alangarf/NRC2016/docs/BillOfMaterials.md

9-pin resistor network:  
* mouser L091S103LF  
* farnell MCRNLA09G0103B0E

USB-B connector:  
* mouser 523-UE27-BC54-130
