alangarf/NRC2016/kicad/banked_ram/banked_ram.kicad_pcb

## KiCad design kicad/banked_ram/banked_ram.kicad_pcb (2016-09-17)

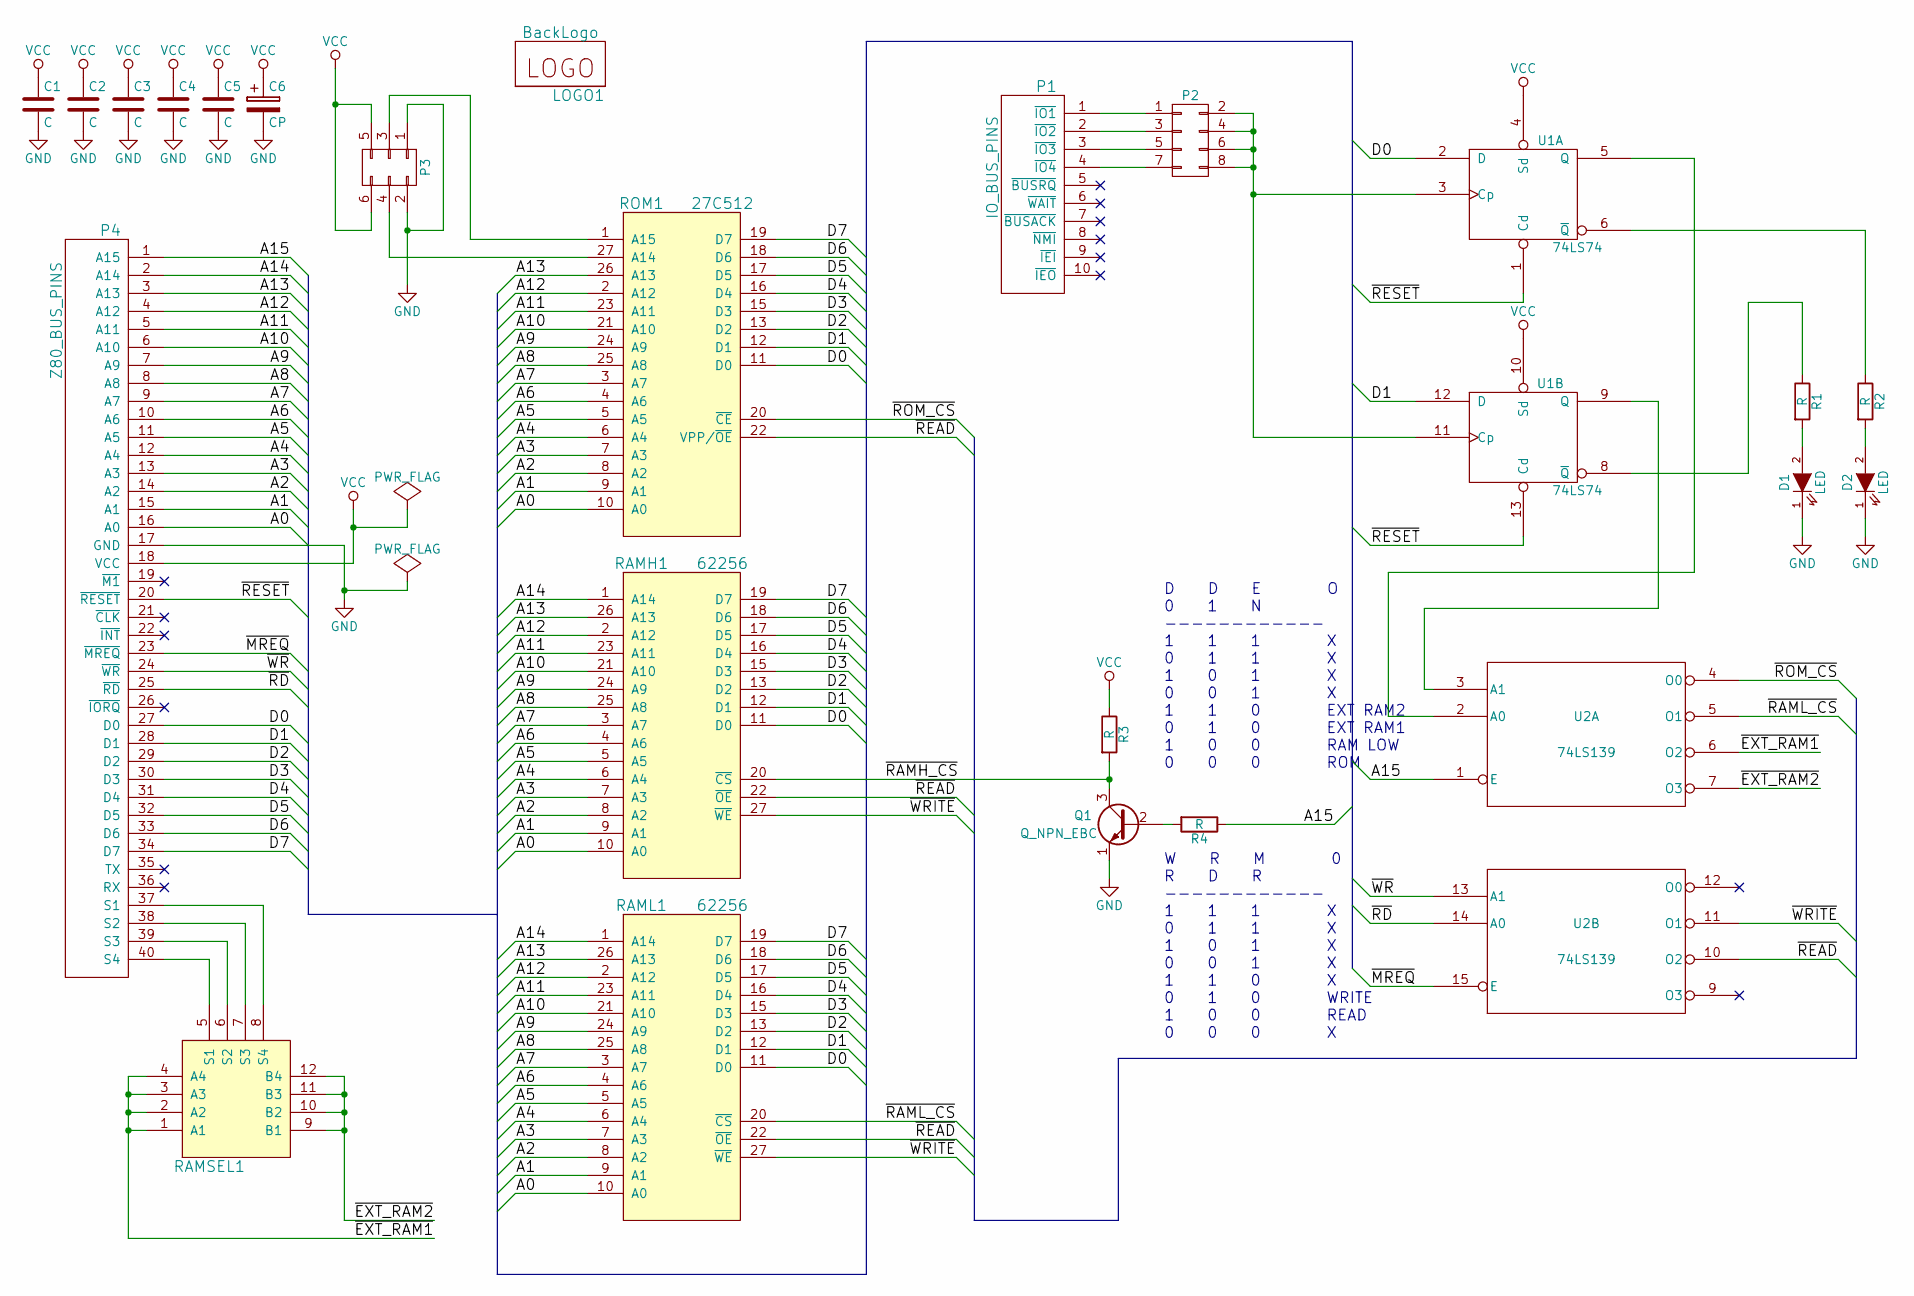
[picture p1: schematic banked_ram.sch]

Parts:
C1, C2, C3, C4, C5: C; C_Disc_D3_P2.5
C6: CP; C_Radial_D5_L11_P2.5
D1, D2: LED; LED-3MM
LOGO1: BackLogo; nrc2016_top_logo_1600
P1: IO_BUS_PINS; Pin_Header_Angled_1x10_nrc2016
P2: CONN_02X04; Pin_Header_Straight_2x04_nrc2016
P3: CONN_02X03; Pin_Header_Straight_2x03
P4: Z80_BUS_PINS; Pin_Header_Angled_1x40_nrc2016
Q1: Q_NPN_EBC; TO-92_Inline_Narrow_Oval
R1, R2, R3, R4: R; Resistor_Horizontal_RM10mm
RAMH1: 62256; DIP-28_W15.24mm_LongPads
RAML1: 62256; DIP-28_W15.24mm_LongPads
RAMSEL1: CONN_04x03; ramsel_pins
ROM1: 27C512; DIP-28_W15.24mm_LongPads
U1: 74LS74; DIP-14_W7.62mm_LongPads
U2: 74LS139; DIP-16_W7.62mm_LongPads

Connections:
/A0: P4.16 (A0), RAMH1.10 (A0), RAML1.10 (A0), ROM1.10 (A0)
/A1: P4.15 (A1), RAMH1.9 (A1), RAML1.9 (A1), ROM1.9 (A1)
/A2: P4.14 (A2), RAMH1.8 (A2), RAML1.8 (A2), ROM1.8 (A2)
/A3: P4.13 (A3), RAMH1.7 (A3), RAML1.7 (A3), ROM1.7 (A3)
/A4: P4.12 (A4), RAMH1.6 (A4), RAML1.6 (A4), ROM1.6 (A4)
/A5: P4.11 (A5), RAMH1.5 (A5), RAML1.5 (A5), ROM1.5 (A5)
/A6: P4.10 (A6), RAMH1.4 (A6), RAML1.4 (A6), ROM1.4 (A6)
/A7: P4.9 (A7), RAMH1.3 (A7), RAML1.3 (A7), ROM1.3 (A7)
/A8: P4.8 (A8), RAMH1.25 (A8), RAML1.25 (A8), ROM1.25 (A8)
/A9: P4.7 (A9), RAMH1.24 (A9), RAML1.24 (A9), ROM1.24 (A9)
/A10: P4.6 (A10), RAMH1.21 (A10), RAML1.21 (A10), ROM1.21 (A10)
/A11: P4.5 (A11), RAMH1.23 (A11), RAML1.23 (A11), ROM1.23 (A11)
/A12: P4.4 (A12), RAMH1.2 (A12), RAML1.2 (A12), ROM1.2 (A12)
/A13: P4.3 (A13), RAMH1.26 (A13), RAML1.26 (A13), ROM1.26 (A13)
/A14: P4.2 (A14), RAMH1.1 (A14), RAML1.1 (A14)
/A15: P4.1 (A15), R4.1, U2.1 (E)
/D0: P4.27 (D0), RAMH1.11 (D0), RAML1.11 (D0), ROM1.11 (D0), U1.2 (D)
/D1: P4.28 (D1), RAMH1.12 (D1), RAML1.12 (D1), ROM1.12 (D1), U1.12 (D)
/D2: P4.29 (D2), RAMH1.13 (D2), RAML1.13 (D2), ROM1.13 (D2)
/D3: P4.30 (D3), RAMH1.15 (D3), RAML1.15 (D3), ROM1.15 (D3)
/D4: P4.31 (D4), RAMH1.16 (D4), RAML1.16 (D4), ROM1.16 (D4)
/D5: P4.32 (D5), RAMH1.17 (D5), RAML1.17 (D5), ROM1.17 (D5)
/D6: P4.33 (D6), RAMH1.18 (D6), RAML1.18 (D6), ROM1.18 (D6)
/D7: P4.34 (D7), RAMH1.19 (D7), RAML1.19 (D7), ROM1.19 (D7)
/~EXT_RAM1: RAMSEL1.1 (A1), RAMSEL1.2 (A2), RAMSEL1.3 (A3), RAMSEL1.4 (A4), U2.6 (O2)
/~EXT_RAM2: RAMSEL1.9 (B1), RAMSEL1.10 (B2), RAMSEL1.11 (B3), RAMSEL1.12 (B4), U2.7 (O3)
/~MREQ: P4.23 (~MREQ), U2.15 (E)
/~RAMH_CS: Q1.3 (C), R3.2, RAMH1.20 (~CS)
/~RAML_CS: RAML1.20 (~CS), U2.5 (O1)
/~RD: P4.25 (~RD), U2.14 (A0)
/~READ: RAMH1.22 (~OE), RAML1.22 (~OE), ROM1.22 (VPP/~OE), U2.10 (O2)
/~RESET: P4.20 (~RESET), U1.1 (Cd), U1.13 (Cd)
/~ROM_CS: ROM1.20 (~CE), U2.4 (O0)
/~WR: P4.24 (~WR), U2.13 (A1)
/~WRITE: RAMH1.27 (~WE), RAML1.27 (~WE), U2.11 (O1)
GND: C1.2, C2.2, C3.2, C4.2, C5.2, C6.2, D1.1 (K), D2.1 (K), P3.1, P3.2, P4.17 (GND), Q1.1 (E), RAMH1.14 (GND), RAML1.14 (GND), ROM1.14 (GND), U1.7 (GND), U2.8 (GND)
unnamed: D1.2 (A), R1.2
unnamed: D2.2 (A), R2.2
unnamed: P1.1 (~IO1), P2.1
unnamed: P1.2 (~IO2), P2.3
unnamed: P1.3 (~IO3), P2.5
unnamed: P1.4 (~IO4), P2.7
unnamed: P2.2, P2.4, P2.6, P2.8, U1.3 (Cp), U1.11 (Cp)
unnamed: P3.3, ROM1.1 (A15)
unnamed: P3.4, ROM1.27 (A14)
unnamed: P4.37 (S1), RAMSEL1.8 (S4)
unnamed: P4.38 (S2), RAMSEL1.7 (S3)
unnamed: P4.39 (S3), RAMSEL1.6 (S2)
unnamed: P4.40 (S4), RAMSEL1.5 (S1)
unnamed: Q1.2 (B), R4.2
unnamed: R1.1, U1.8 (~Q)
unnamed: R2.1, U1.6 (~Q)
unnamed: U1.5 (Q), U2.2 (A0)
unnamed: U1.9 (Q), U2.3 (A1)
VCC: C1.1, C2.1, C3.1, C4.1, C5.1, C6.1, P3.5, P3.6, P4.18 (VCC), R3.1, RAMH1.28 (VCC), RAML1.28 (VCC), ROM1.28 (VCC), U1.4 (Sd), U1.10 (Sd), U1.14 (VCC), U2.16 (VCC)

Notes on the sheet:
W R M 0 R D R ------------ 1 1 1 X 0 1 1 X 1 0 1 X 0 0 1 X 1 1 0 X 0 1 0 WRITE 1 0 0 READ 0 0 0 X
D D E O 0 1 N ------------ 1 1 1 X 0 1 1 X 1 0 1 X 0 0 1 X 1 1 0 EXT RAM2 0 1 0 EXT RAM1 1 0 0 RAM LOW 0 0 0 ROM

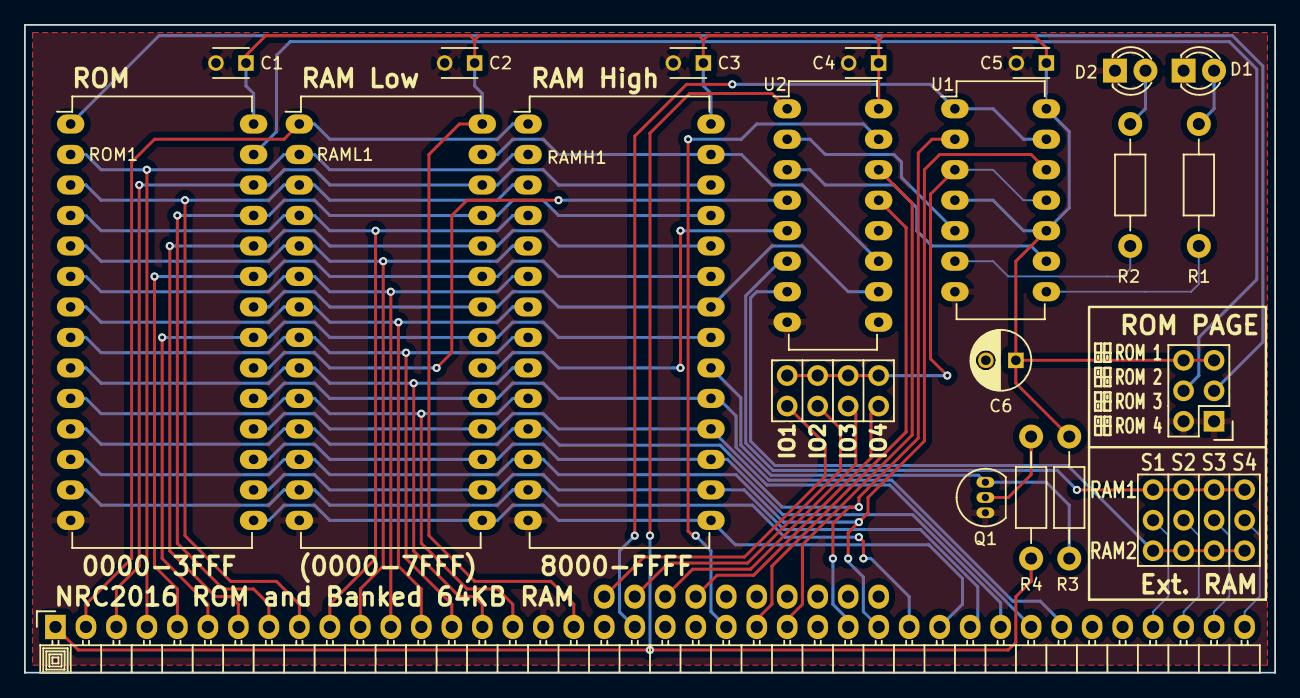
[picture p2: board banked_ram.kicad_pcb from above]

Board: 2 copper layers, 104.1 x 54.0 mm, 24 parts (0 on the bottom side), 55 nets.
