alangarf/NRC2016/kicad/usb_sio/usb_sio.kicad_pcb

## KiCad design kicad/usb_sio/usb_sio.kicad_pcb (2016-09-17)

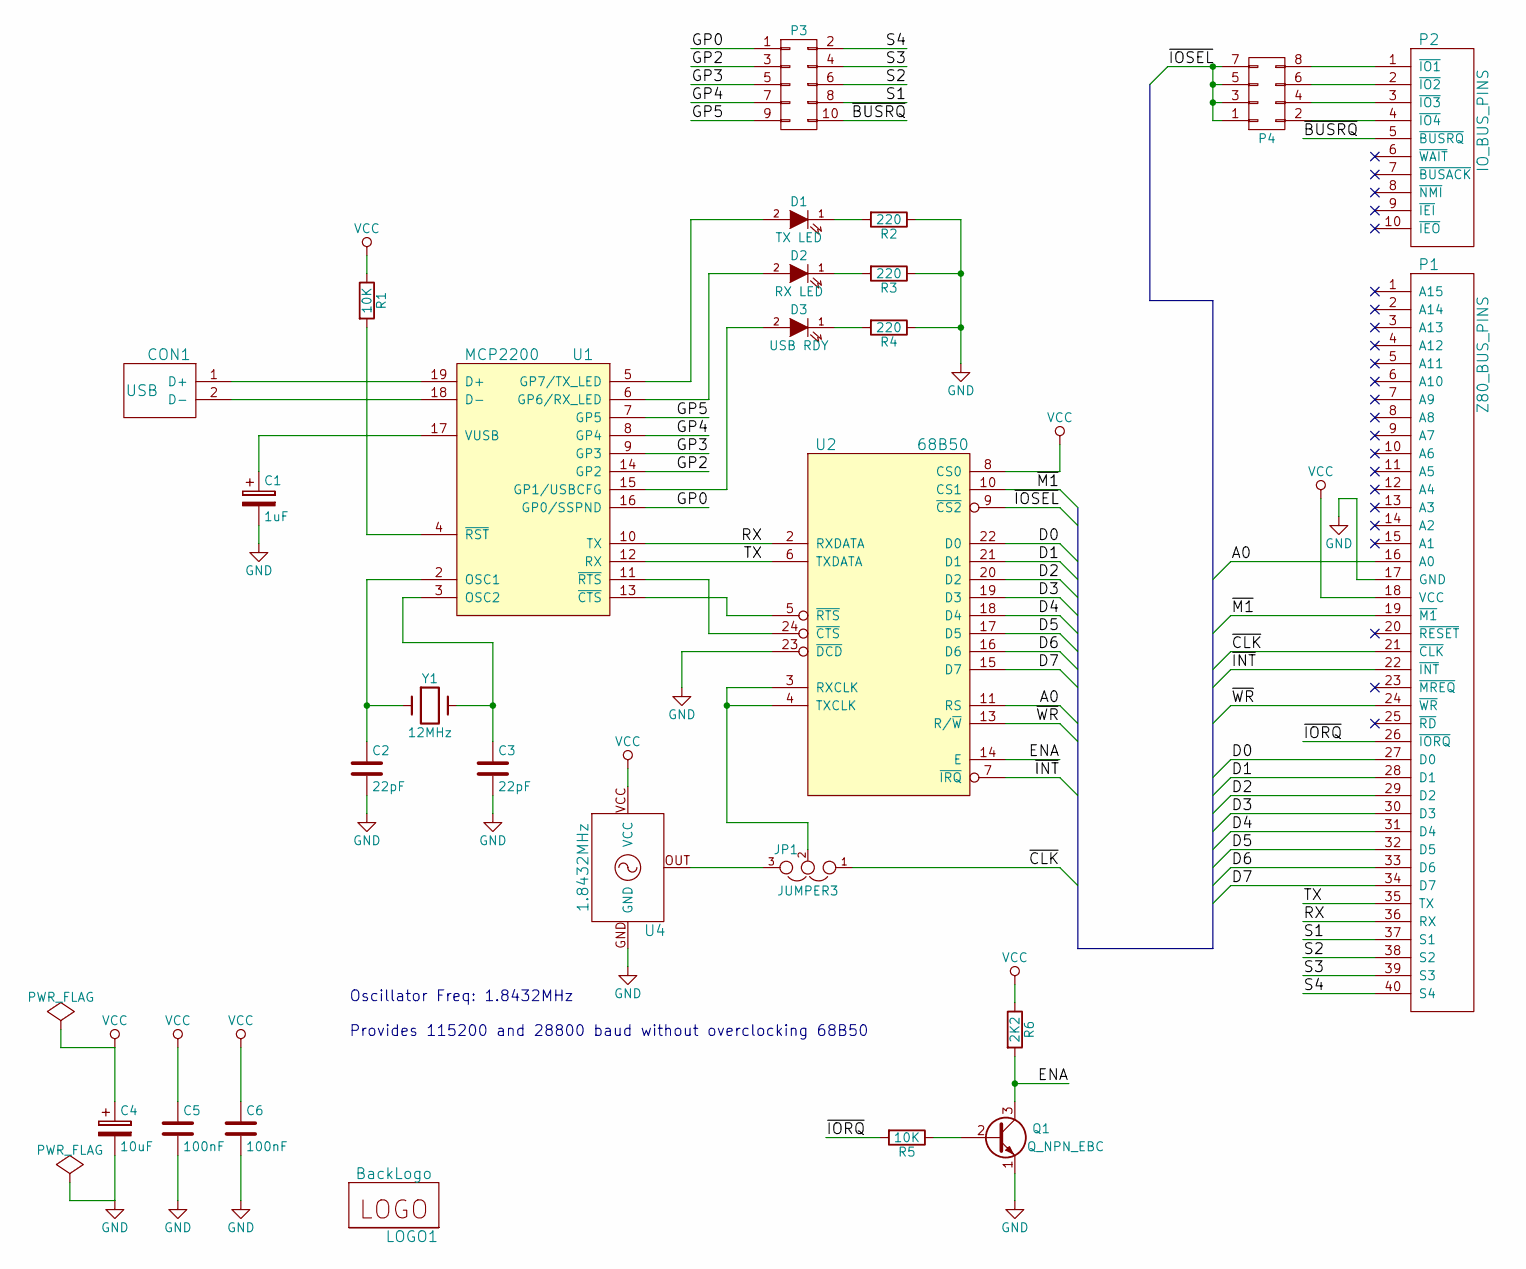
[picture p3: schematic usb_sio.sch]

Parts:
C1: 1uF; C_Radial_D5_L6_P2.5
C2, C3: 22pF; C_Disc_D3_P2.5
C4: 10uF; C_Radial_D6.3_L11.2_P2.5
C5, C6: 100nF; C_Disc_D3_P2.5
CON1: USB; Pin_Header_Angled_1x02_nrc2016
D1: TX LED; LED-3MM
D2: RX LED; LED-3MM
D3: USB RDY; LED-3MM
JP1: JUMPER3; Pin_Header_Straight_1x03
LOGO1: BackLogo; nrc2016_top_logo_1600
P1: Z80_BUS_PINS; Pin_Header_Angled_1x40_nrc2016
P2: IO_BUS_PINS; Pin_Header_Angled_1x10_nrc2016
P3: CONN_02X05; Pin_Header_Straight_2x05
P4: CONN_02X04; Pin_Header_Straight_2x04
Q1: Q_NPN_EBC; TO-92_Molded_Narrow
R1, R5: 10K; Resistor_Horizontal_RM10mm
R2, R3, R4: 220; Resistor_Horizontal_RM10mm
R6: 2K2; Resistor_Horizontal_RM10mm
U1: MCP2200; SOIC-20W_7.5x12.8mm_Pitch1.27mm
U2: 68B50; DIP-24_W15.24mm_LongPads
U4: 1.8432MHz; OSC_MULTIPACKAGE_DIP
Y1: 12MHz; Crystal_HC49-U_Vertical

Connections:
/A0: P1.16 (A0), U2.11 (RS)
/D0: P1.27 (D0), U2.22 (D0)
/D1: P1.28 (D1), U2.21 (D1)
/D2: P1.29 (D2), U2.20 (D2)
/D3: P1.30 (D3), U2.19 (D3)
/D4: P1.31 (D4), U2.18 (D4)
/D5: P1.32 (D5), U2.17 (D5)
/D6: P1.33 (D6), U2.16 (D6)
/D7: P1.34 (D7), U2.15 (D7)
/ENA: Q1.3 (C), R6.2, U2.14 (E)
/GP0: P3.1, U1.16 (GP0/SSPND)
/GP2: P3.3, U1.14 (GP2)
/GP3: P3.5, U1.9 (GP3)
/GP4: P3.7, U1.8 (GP4)
/GP5: P3.9, U1.7 (GP5)
/RX: P1.36 (RX), U1.10 (TX), U2.2 (RXDATA)
/S1: P1.37 (S1), P3.8
/S2: P1.38 (S2), P3.6
/S3: P1.39 (S3), P3.4
/S4: P1.40 (S4), P3.2
/TX: P1.35 (TX), U1.12 (RX), U2.6 (TXDATA)
/~BUSRQ: P2.5 (~BUSRQ), P3.10
/~CLK: JP1.1, P1.21 (~CLK)
/~INT: P1.22 (~INT), U2.7 (~IRQ)
/~IORQ: P1.26 (~IORQ), R5.2
/~IOSEL: P4.1, P4.3, P4.5, P4.7, U2.9 (~CS2)
/~M1: P1.19 (~M1), U2.10 (CS1)
/~WR: P1.24 (~WR), U2.13 (R/~W)
GND: C1.2, C2.2, C3.2, C4.2, C5.2, C6.2, P1.17 (GND), Q1.1 (E), R2.1, R3.1, R4.1, U1.20 (GND), U2.1 (GND), U2.23 (~DCD), U4.GND
unnamed: C1.1, U1.17 (VUSB)
unnamed: C2.1, U1.2 (OSC1), Y1.1
unnamed: C3.1, U1.3 (OSC2), Y1.2
unnamed: CON1.1 (D+), U1.19 (D+)
unnamed: CON1.2 (D-), U1.18 (D-)
unnamed: D1.1 (K), R2.2
unnamed: D1.2 (A), U1.5 (GP7/TX_LED)
unnamed: D2.1 (K), R3.2
unnamed: D2.2 (A), U1.6 (GP6/RX_LED)
unnamed: D3.1 (K), R4.2
unnamed: D3.2 (A), U1.15 (GP1/USBCFG)
unnamed: JP1.2, U2.3 (RXCLK), U2.4 (TXCLK)
unnamed: JP1.3, U4.OUT
unnamed: P2.1 (~IO1), P4.8
unnamed: P2.2 (~IO2), P4.6
unnamed: P2.3 (~IO3), P4.4
unnamed: P2.4 (~IO4), P4.2
unnamed: Q1.2 (B), R5.1
unnamed: R1.2, U1.4 (~RST)
unnamed: U1.11 (~RTS), U2.24 (~CTS)
unnamed: U1.13 (~CTS), U2.5 (~RTS)
VCC: C4.1, C5.1, C6.1, P1.18 (VCC), R1.1, R6.1, U1.1 (VCC), U2.8 (CS0), U2.12 (VCC), U4.VCC

Notes on the sheet:
Oscillator Freq: 1.8432MHz Provides 115200 and 28800 baud without overclocking 68B50

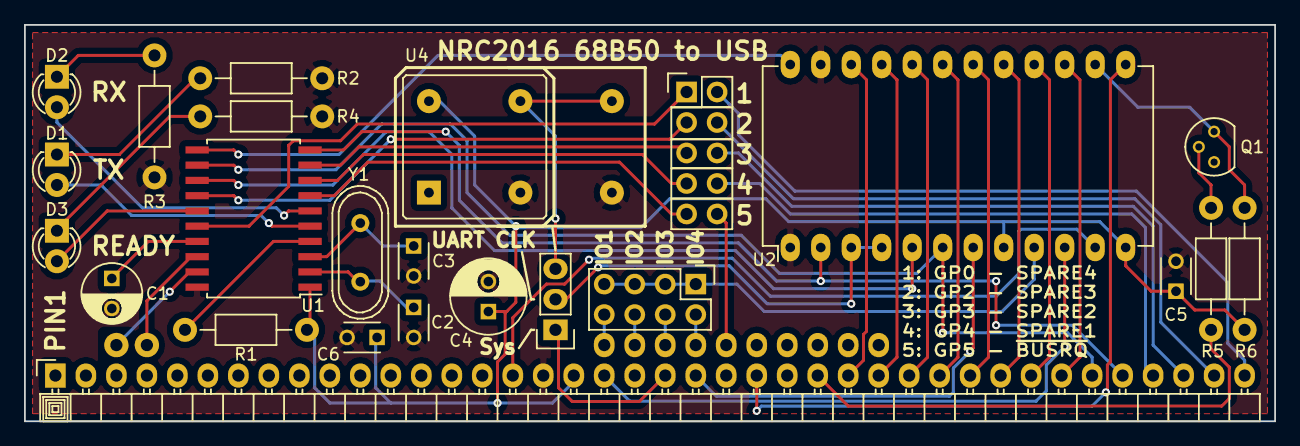
[picture p4: board usb_sio.kicad_pcb from above]

Board: 2 copper layers, 104.1 x 33.0 mm, 27 parts (0 on the bottom side), 51 nets.
