alangarf/NRC2016/kicad/nrc2016/z80.kicad_pcb

## KiCad design kicad/nrc2016/z80.kicad_pcb (2016-09-10)

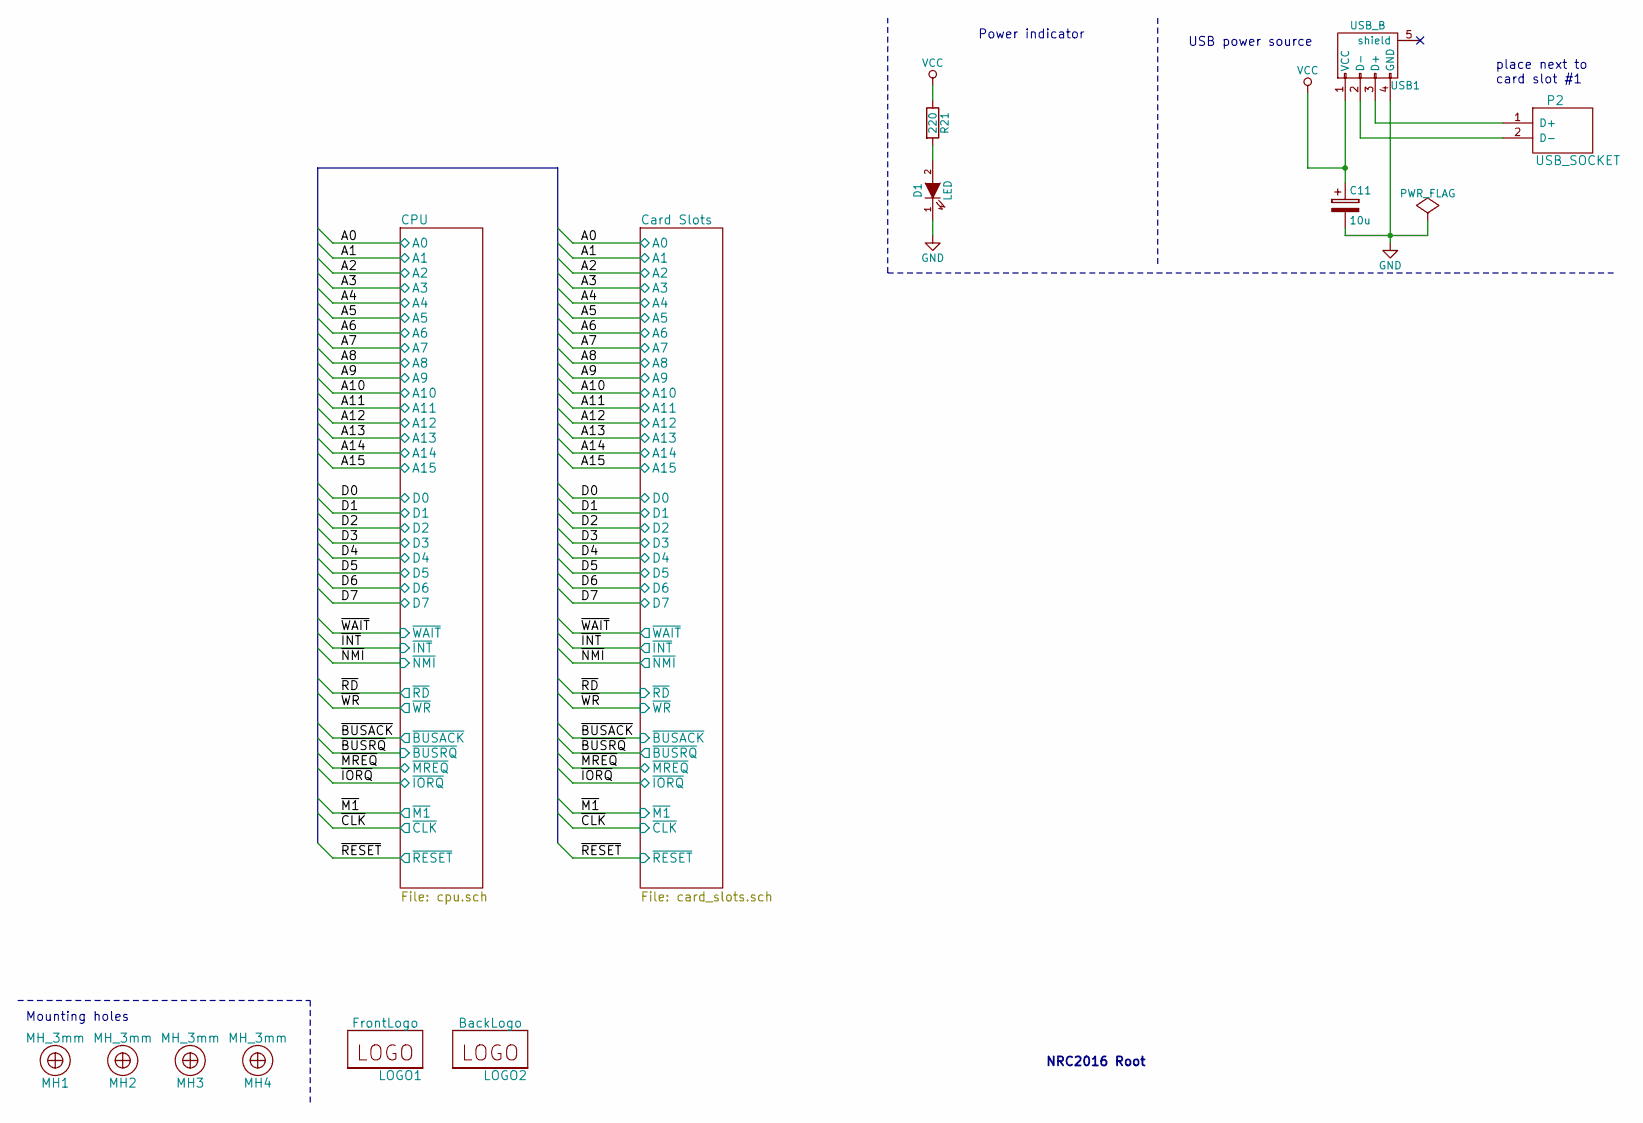
[picture p5: schematic z80.sch]

Parts:
C11: 10u; C_Radial_D6.3_L11.2_P2.5
D1: LED; LED-3MM
LOGO1: FrontLogo; nrc2016_top_logo_1600
LOGO2: BackLogo; nrc2016_bottom_logo_600_v2
MH1, MH2, MH3, MH4: MH_3mm; MountingHole_3.2mm_M3
P2: USB_SOCKET; Socket_Strip_Straight_1x02
R21: 220; Resistor_Horizontal_RM7mm
USB1: USB_B

Connections:
GND: C11.2, D1.1 (K), USB1.4 (GND); also elsewhere on the board
unnamed: D1.2 (A), R21.2
unnamed: P2.1 (D+), USB1.3 (D+)
unnamed: P2.2 (D-), USB1.2 (D-)
VCC: C11.1, R21.1, USB1.1 (VCC); also elsewhere on the board

Notes on the sheet:
NRC2016 Root
Mounting holes
USB power source
Power indicator
place next to card slot #1

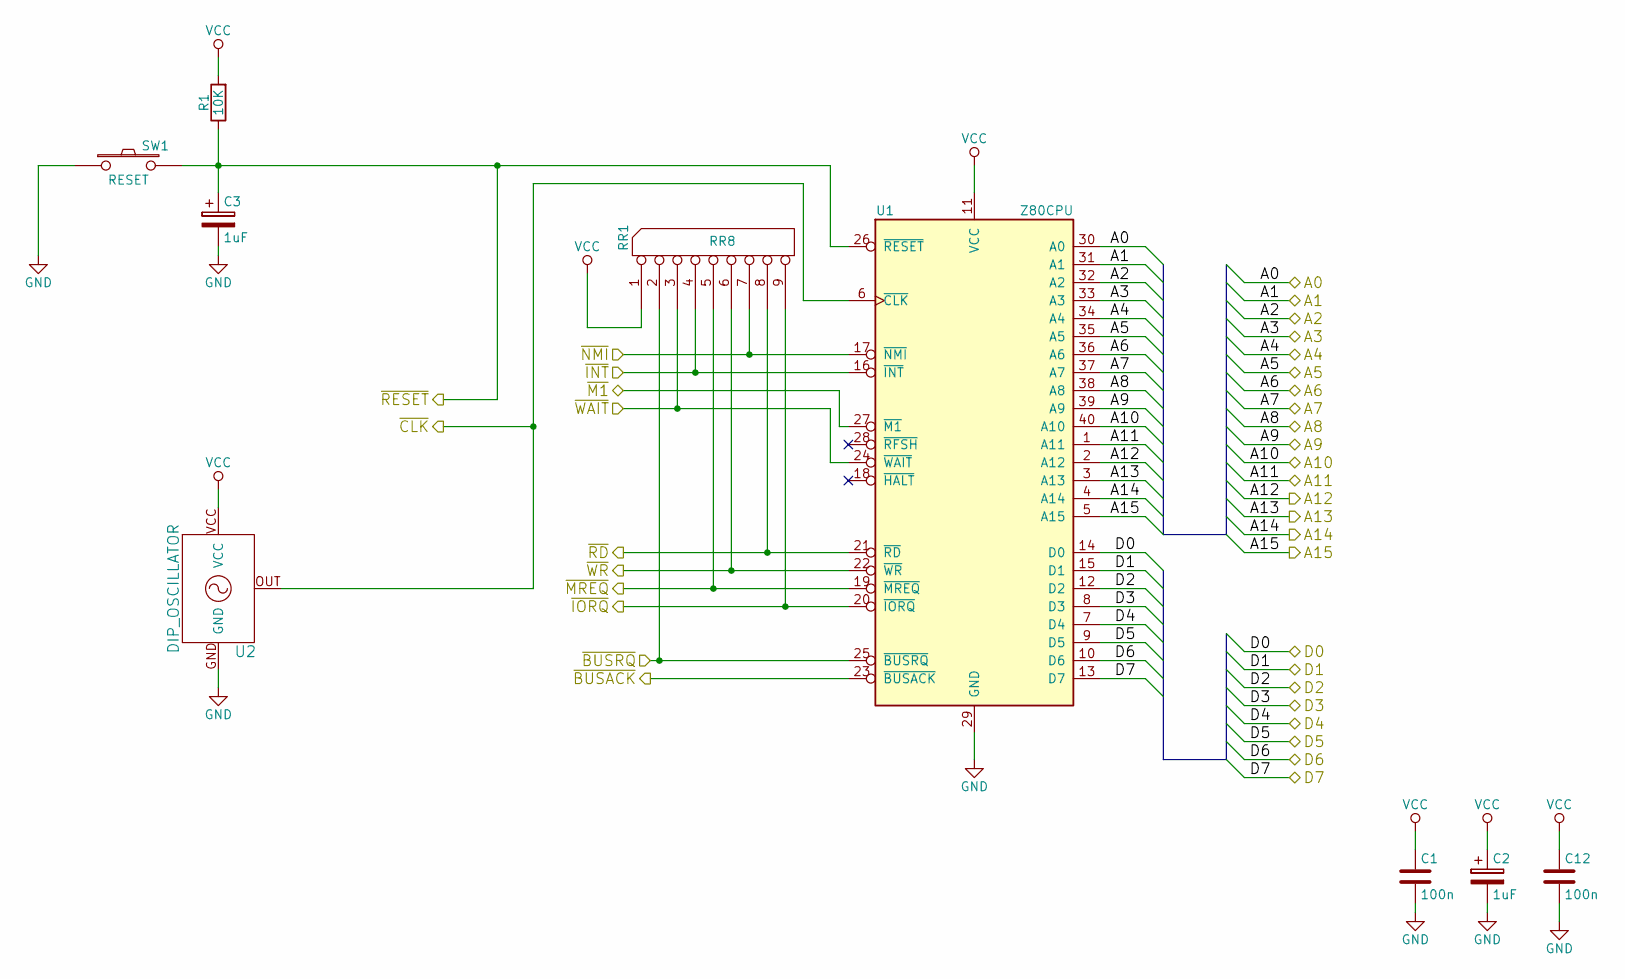
[picture p6: schematic cpu.sch]

Parts:
C1, C12: 100n; C_Rect_L4_W2.5_P2.5
C2, C3: 1uF; C_Radial_D5_L6_P2.5
R1: 10K; Resistor_Horizontal_RM7mm
RR1: RR8; Resistor_Array_SIP8
SW1: RESET; SW_PUSH_SMALL
U1: Z80CPU; DIP-40_W15.24mm_LongPads
U2: DIP_OSCILLATOR; OSC_MULTIPACKAGE_DIP

Connections:
/A0: U1.30 (A0); also elsewhere on the board
/A1: U1.31 (A1); also elsewhere on the board
/A2: U1.32 (A2); also elsewhere on the board
/A3: U1.33 (A3); also elsewhere on the board
/A4: U1.34 (A4); also elsewhere on the board
/A5: U1.35 (A5); also elsewhere on the board
/A6: U1.36 (A6); also elsewhere on the board
/A7: U1.37 (A7); also elsewhere on the board
/A8: U1.38 (A8); also elsewhere on the board
/A9: U1.39 (A9); also elsewhere on the board
/A10: U1.40 (A10); also elsewhere on the board
/A11: U1.1 (A11); also elsewhere on the board
/A12: U1.2 (A12); also elsewhere on the board
/A13: U1.3 (A13); also elsewhere on the board
/A14: U1.4 (A14); also elsewhere on the board
/A15: U1.5 (A15); also elsewhere on the board
/D0: U1.14 (D0); also elsewhere on the board
/D1: U1.15 (D1); also elsewhere on the board
/D2: U1.12 (D2); also elsewhere on the board
/D3: U1.8 (D3); also elsewhere on the board
/D4: U1.7 (D4); also elsewhere on the board
/D5: U1.9 (D5); also elsewhere on the board
/D6: U1.10 (D6); also elsewhere on the board
/D7: U1.13 (D7); also elsewhere on the board
/~BUSACK: U1.23 (~BUSACK~); also elsewhere on the board
/~BUSRQ: RR1.2, U1.25 (~BUSRQ~); also elsewhere on the board
/~CLK: U1.6 (~CLK~), U2.OUT; also elsewhere on the board
/~INT: RR1.4, U1.16 (~INT~); also elsewhere on the board
/~IORQ: RR1.9, U1.20 (~IORQ~); also elsewhere on the board
/~M1: U1.27 (~M1~); also elsewhere on the board
/~MREQ: RR1.5, U1.19 (~MREQ~); also elsewhere on the board
/~NMI: RR1.7, U1.17 (~NMI~); also elsewhere on the board
/~RD: RR1.8, U1.21 (~RD~); also elsewhere on the board
/~RESET: C3.1, R1.1, SW1.2, U1.26 (~RESET~); also elsewhere on the board
/~WAIT: RR1.3, U1.24 (~WAIT~); also elsewhere on the board
/~WR: RR1.6, U1.22 (~WR~); also elsewhere on the board
GND: C1.2, C2.2, C3.2, C12.2, SW1.1, U1.29 (GND), U2.GND; also elsewhere on the board
VCC: C1.1, C2.1, C12.1, R1.2, RR1.1 (COM), U1.11 (VCC), U2.VCC; also elsewhere on the board

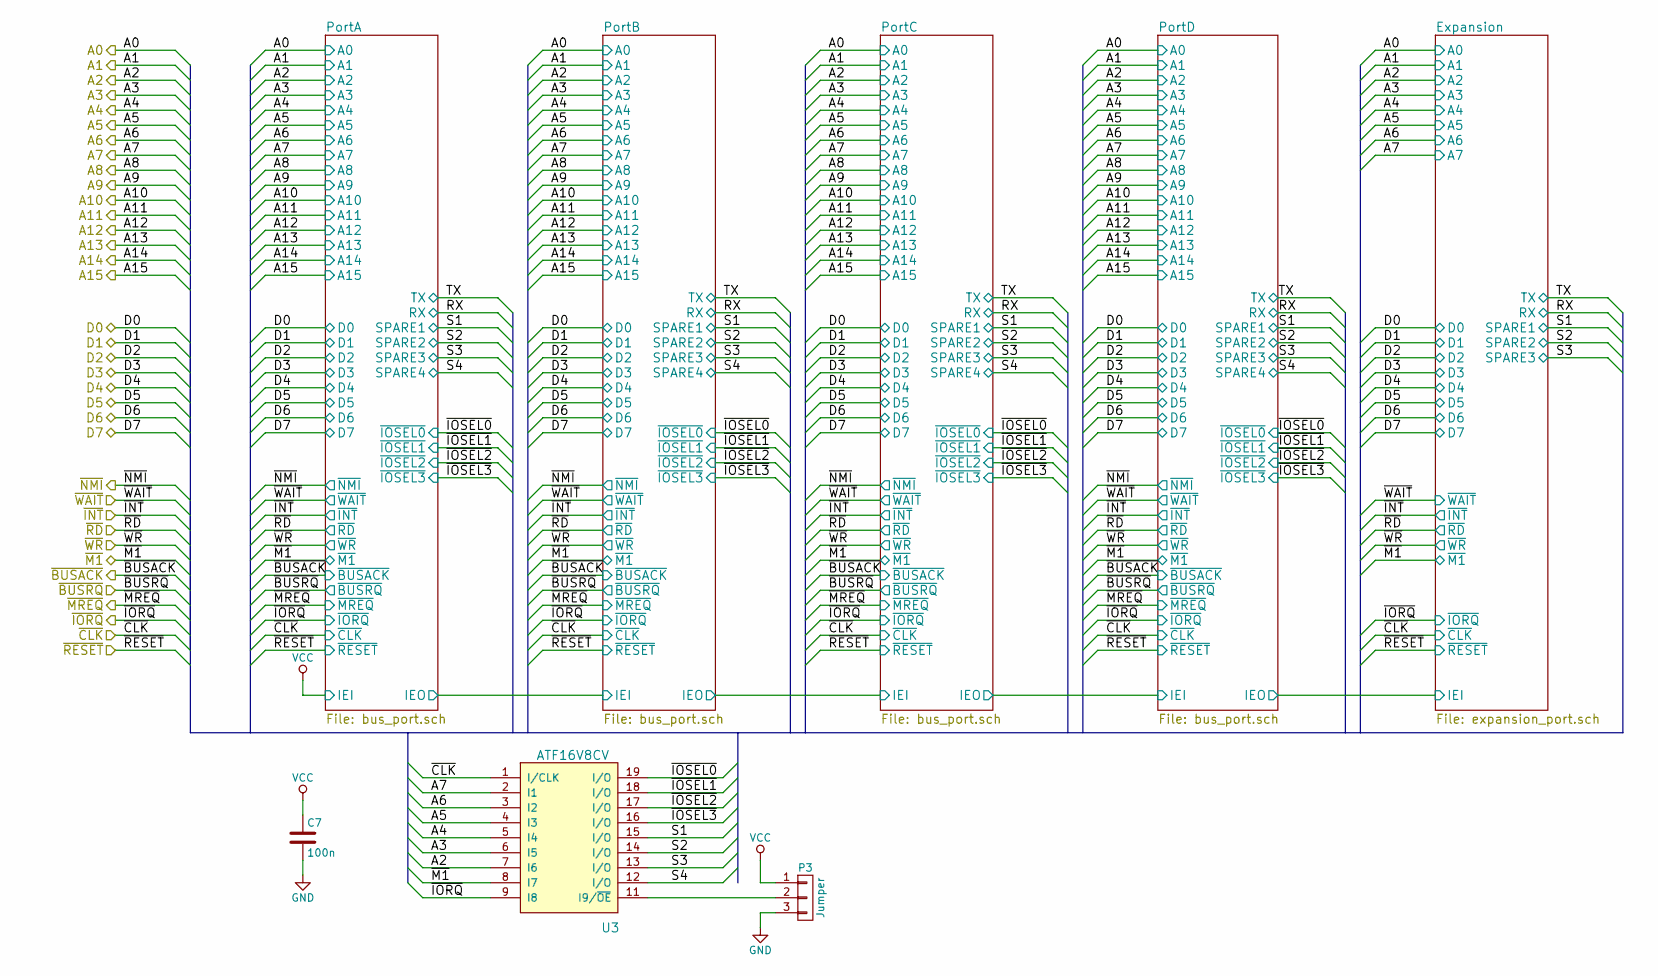
[picture p7: schematic card_slots.sch]

Parts:
C7: 100n; C_Rect_L4_W2.5_P2.5
P3: Jumper; Pin_Header_Straight_1x03
U3: ATF16V8CV; DIP-20_W7.62mm_LongPads

Connections:
/A2: U3.7 (I6); also elsewhere on the board
/A3: U3.6 (I5); also elsewhere on the board
/A4: U3.5 (I4); also elsewhere on the board
/A5: U3.4 (I3); also elsewhere on the board
/A6: U3.3 (I2); also elsewhere on the board
/A7: U3.2 (I1); also elsewhere on the board
/Card Slots/S1: U3.15 (I/O); also elsewhere on the board
/Card Slots/S2: U3.14 (I/O); also elsewhere on the board
/Card Slots/S3: U3.13 (I/O); also elsewhere on the board
/Card Slots/S4: U3.12 (I/O); also elsewhere on the board
/Card Slots/~IOSEL0: U3.19 (I/O); also elsewhere on the board
/Card Slots/~IOSEL1: U3.18 (I/O); also elsewhere on the board
/Card Slots/~IOSEL2: U3.17 (I/O); also elsewhere on the board
/Card Slots/~IOSEL3: U3.16 (I/O); also elsewhere on the board
/~CLK: U3.1 (I/CLK); also elsewhere on the board
/~IORQ: U3.9 (I8); also elsewhere on the board
/~M1: U3.8 (I7); also elsewhere on the board
GND: C7.2, P3.3, U3.10 (GND); also elsewhere on the board
unnamed: P3.2, U3.11 (I9/~OE)
VCC: C7.1, P3.1, U3.20 (VCC); also elsewhere on the board

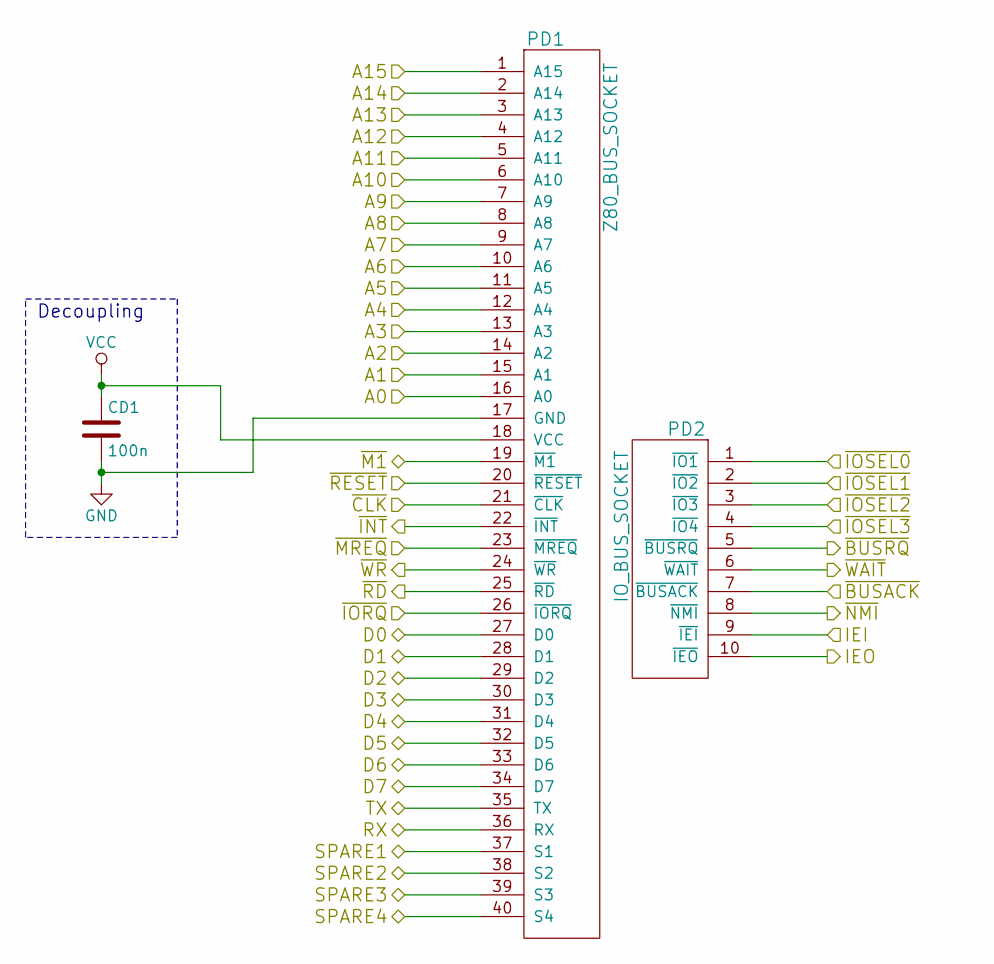
[picture p8: schematic bus_port.sch]

Parts:
CA1: 100n; C_Rect_L4_W2.5_P2.5
PA1: Z80_BUS_SOCKET; Socket_Strip_Straight_1x40
PA2: IO_BUS_SOCKET; Socket_Strip_Straight_1x10_NRC2016

Connections:
/A0: PA1.16 (A0); also elsewhere on the board
/A1: PA1.15 (A1); also elsewhere on the board
/A2: PA1.14 (A2); also elsewhere on the board
/A3: PA1.13 (A3); also elsewhere on the board
/A4: PA1.12 (A4); also elsewhere on the board
/A5: PA1.11 (A5); also elsewhere on the board
/A6: PA1.10 (A6); also elsewhere on the board
/A7: PA1.9 (A7); also elsewhere on the board
/A8: PA1.8 (A8); also elsewhere on the board
/A9: PA1.7 (A9); also elsewhere on the board
/A10: PA1.6 (A10); also elsewhere on the board
/A11: PA1.5 (A11); also elsewhere on the board
/A12: PA1.4 (A12); also elsewhere on the board
/A13: PA1.3 (A13); also elsewhere on the board
/A14: PA1.2 (A14); also elsewhere on the board
/A15: PA1.1 (A15); also elsewhere on the board
/Card Slots/PortB/IEI: PA2.10 (~IEO); also elsewhere on the board
/Card Slots/RX: PA1.36 (RX); also elsewhere on the board
/Card Slots/S1: PA1.37 (S1); also elsewhere on the board
/Card Slots/S2: PA1.38 (S2); also elsewhere on the board
/Card Slots/S3: PA1.39 (S3); also elsewhere on the board
/Card Slots/S4: PA1.40 (S4); also elsewhere on the board
/Card Slots/TX: PA1.35 (TX); also elsewhere on the board
/Card Slots/~IOSEL0: PA2.1 (~IO1); also elsewhere on the board
/Card Slots/~IOSEL1: PA2.2 (~IO2); also elsewhere on the board
/Card Slots/~IOSEL2: PA2.3 (~IO3); also elsewhere on the board
/Card Slots/~IOSEL3: PA2.4 (~IO4); also elsewhere on the board
/D0: PA1.27 (D0); also elsewhere on the board
/D1: PA1.28 (D1); also elsewhere on the board
/D2: PA1.29 (D2); also elsewhere on the board
/D3: PA1.30 (D3); also elsewhere on the board
/D4: PA1.31 (D4); also elsewhere on the board
/D5: PA1.32 (D5); also elsewhere on the board
/D6: PA1.33 (D6); also elsewhere on the board
/D7: PA1.34 (D7); also elsewhere on the board
/~BUSACK: PA2.7 (~BUSACK); also elsewhere on the board
/~BUSRQ: PA2.5 (~BUSRQ); also elsewhere on the board
/~CLK: PA1.21 (~CLK); also elsewhere on the board
/~INT: PA1.22 (~INT); also elsewhere on the board
/~IORQ: PA1.26 (~IORQ); also elsewhere on the board
/~M1: PA1.19 (~M1); also elsewhere on the board
/~MREQ: PA1.23 (~MREQ); also elsewhere on the board
/~NMI: PA2.8 (~NMI); also elsewhere on the board
/~RD: PA1.25 (~RD); also elsewhere on the board
/~RESET: PA1.20 (~RESET); also elsewhere on the board
/~WAIT: PA2.6 (~WAIT); also elsewhere on the board
/~WR: PA1.24 (~WR); also elsewhere on the board
GND: CA1.2, PA1.17 (GND); also elsewhere on the board
VCC: CA1.1, PA1.18 (VCC), PA2.9 (~IEI); also elsewhere on the board

Parts of its further copies:
CB1, CB2: 100n; C_Rect_L4_W2.5_P2.5
CC1: 100n; C_Rect_L4_W2.5_P2.5
CD1: 100n; C_Rect_L4_W2.5_P2.5
PB1: Z80_BUS_SOCKET; Socket_Strip_Straight_1x40
PB2: IO_BUS_SOCKET; Socket_Strip_Straight_1x10_NRC2016
PC1: Z80_BUS_SOCKET; Socket_Strip_Straight_1x40
PC2: IO_BUS_SOCKET; Socket_Strip_Straight_1x10_NRC2016
PD1: Z80_BUS_SOCKET; Socket_Strip_Straight_1x40
PD2: IO_BUS_SOCKET; Socket_Strip_Straight_1x10_NRC2016

Connections of its further copies:
/A0: PB1.16 (A0), PC1.16 (A0), PD1.16 (A0); also elsewhere on the board
/A1: PB1.15 (A1), PC1.15 (A1), PD1.15 (A1); also elsewhere on the board
/A2: PB1.14 (A2), PC1.14 (A2), PD1.14 (A2); also elsewhere on the board
/A3: PB1.13 (A3), PC1.13 (A3), PD1.13 (A3); also elsewhere on the board
/A4: PB1.12 (A4), PC1.12 (A4), PD1.12 (A4); also elsewhere on the board
/A5: PB1.11 (A5), PC1.11 (A5), PD1.11 (A5); also elsewhere on the board
/A6: PB1.10 (A6), PC1.10 (A6), PD1.10 (A6); also elsewhere on the board
/A7: PB1.9 (A7), PC1.9 (A7), PD1.9 (A7); also elsewhere on the board
/A8: PB1.8 (A8), PC1.8 (A8), PD1.8 (A8); also elsewhere on the board
/A9: PB1.7 (A9), PC1.7 (A9), PD1.7 (A9); also elsewhere on the board
/A10: PB1.6 (A10), PC1.6 (A10), PD1.6 (A10); also elsewhere on the board
/A11: PB1.5 (A11), PC1.5 (A11), PD1.5 (A11); also elsewhere on the board
/A12: PB1.4 (A12), PC1.4 (A12), PD1.4 (A12); also elsewhere on the board
/A13: PB1.3 (A13), PC1.3 (A13), PD1.3 (A13); also elsewhere on the board
/A14: PB1.2 (A14), PC1.2 (A14), PD1.2 (A14); also elsewhere on the board
/A15: PB1.1 (A15), PC1.1 (A15), PD1.1 (A15); also elsewhere on the board
/Card Slots/Expansion/IEI: PD2.10 (~IEO); also elsewhere on the board
/Card Slots/PortB/IEI: PB2.9 (~IEI); also elsewhere on the board
/Card Slots/PortC/IEI: PB2.10 (~IEO), PC2.9 (~IEI)
/Card Slots/PortD/IEI: PC2.10 (~IEO), PD2.9 (~IEI)
/Card Slots/RX: PB1.36 (RX), PC1.36 (RX), PD1.36 (RX); also elsewhere on the board
/Card Slots/S1: PB1.37 (S1), PC1.37 (S1), PD1.37 (S1); also elsewhere on the board
/Card Slots/S2: PB1.38 (S2), PC1.38 (S2), PD1.38 (S2); also elsewhere on the board
/Card Slots/S3: PB1.39 (S3), PC1.39 (S3), PD1.39 (S3); also elsewhere on the board
/Card Slots/S4: PB1.40 (S4), PC1.40 (S4), PD1.40 (S4); also elsewhere on the board
/Card Slots/TX: PB1.35 (TX), PC1.35 (TX), PD1.35 (TX); also elsewhere on the board
/Card Slots/~IOSEL0: PB2.1 (~IO1), PC2.1 (~IO1), PD2.1 (~IO1); also elsewhere on the board
/Card Slots/~IOSEL1: PB2.2 (~IO2), PC2.2 (~IO2), PD2.2 (~IO2); also elsewhere on the board
/Card Slots/~IOSEL2: PB2.3 (~IO3), PC2.3 (~IO3), PD2.3 (~IO3); also elsewhere on the board
/Card Slots/~IOSEL3: PB2.4 (~IO4), PC2.4 (~IO4), PD2.4 (~IO4); also elsewhere on the board
/D0: PB1.27 (D0), PC1.27 (D0), PD1.27 (D0); also elsewhere on the board
/D1: PB1.28 (D1), PC1.28 (D1), PD1.28 (D1); also elsewhere on the board
/D2: PB1.29 (D2), PC1.29 (D2), PD1.29 (D2); also elsewhere on the board
/D3: PB1.30 (D3), PC1.30 (D3), PD1.30 (D3); also elsewhere on the board
/D4: PB1.31 (D4), PC1.31 (D4), PD1.31 (D4); also elsewhere on the board
/D5: PB1.32 (D5), PC1.32 (D5), PD1.32 (D5); also elsewhere on the board
/D6: PB1.33 (D6), PC1.33 (D6), PD1.33 (D6); also elsewhere on the board
/D7: PB1.34 (D7), PC1.34 (D7), PD1.34 (D7); also elsewhere on the board
/~BUSACK: PB2.7 (~BUSACK), PC2.7 (~BUSACK), PD2.7 (~BUSACK); also elsewhere on the board
/~BUSRQ: PB2.5 (~BUSRQ), PC2.5 (~BUSRQ), PD2.5 (~BUSRQ); also elsewhere on the board
/~CLK: PB1.21 (~CLK), PC1.21 (~CLK), PD1.21 (~CLK); also elsewhere on the board
/~INT: PB1.22 (~INT), PC1.22 (~INT), PD1.22 (~INT); also elsewhere on the board
/~IORQ: PB1.26 (~IORQ), PC1.26 (~IORQ), PD1.26 (~IORQ); also elsewhere on the board
/~M1: PB1.19 (~M1), PC1.19 (~M1), PD1.19 (~M1); also elsewhere on the board
/~MREQ: PB1.23 (~MREQ), PC1.23 (~MREQ), PD1.23 (~MREQ); also elsewhere on the board
/~NMI: PB2.8 (~NMI), PC2.8 (~NMI), PD2.8 (~NMI); also elsewhere on the board
/~RD: PB1.25 (~RD), PC1.25 (~RD), PD1.25 (~RD); also elsewhere on the board
/~RESET: PB1.20 (~RESET), PC1.20 (~RESET), PD1.20 (~RESET); also elsewhere on the board
/~WAIT: PB2.6 (~WAIT), PC2.6 (~WAIT), PD2.6 (~WAIT); also elsewhere on the board
/~WR: PB1.24 (~WR), PC1.24 (~WR), PD1.24 (~WR); also elsewhere on the board
GND: CB1.2, CC1.2, CD1.2, PB1.17 (GND), PC1.17 (GND), PD1.17 (GND); also elsewhere on the board
VCC: CB1.1, CC1.1, CD1.1, PB1.18 (VCC), PC1.18 (VCC), PD1.18 (VCC); also elsewhere on the board

Notes on the sheet:
Decoupling
