alangarf/NRC2016/kicad/nrc2016/z80.kicad_pcb

## KiCad design kicad/nrc2016/z80.kicad_pcb (continued)

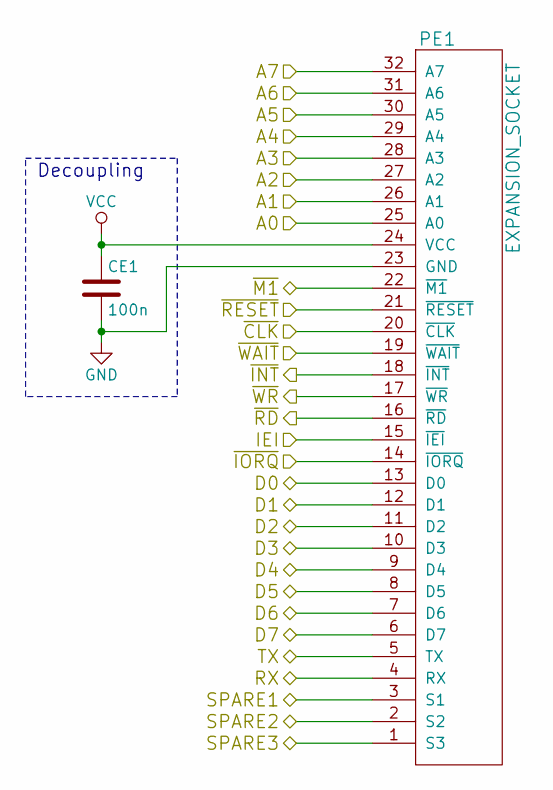
[picture p9: schematic expansion_port.sch]

Parts:
CE1: 100n; C_Rect_L4_W2.5_P2.5
PE1: EXPANSION_SOCKET; Socket_Strip_Angled_1x32

Connections:
/A0: PE1.25 (A0); also elsewhere on the board
/A1: PE1.26 (A1); also elsewhere on the board
/A2: PE1.27 (A2); also elsewhere on the board
/A3: PE1.28 (A3); also elsewhere on the board
/A4: PE1.29 (A4); also elsewhere on the board
/A5: PE1.30 (A5); also elsewhere on the board
/A6: PE1.31 (A6); also elsewhere on the board
/A7: PE1.32 (A7); also elsewhere on the board
/Card Slots/Expansion/IEI: PE1.15 (~IEI); also elsewhere on the board
/Card Slots/RX: PE1.4 (RX); also elsewhere on the board
/Card Slots/S1: PE1.3 (S1); also elsewhere on the board
/Card Slots/S2: PE1.2 (S2); also elsewhere on the board
/Card Slots/S3: PE1.1 (S3); also elsewhere on the board
/Card Slots/TX: PE1.5 (TX); also elsewhere on the board
/D0: PE1.13 (D0); also elsewhere on the board
/D1: PE1.12 (D1); also elsewhere on the board
/D2: PE1.11 (D2); also elsewhere on the board
/D3: PE1.10 (D3); also elsewhere on the board
/D4: PE1.9 (D4); also elsewhere on the board
/D5: PE1.8 (D5); also elsewhere on the board
/D6: PE1.7 (D6); also elsewhere on the board
/D7: PE1.6 (D7); also elsewhere on the board
/~CLK: PE1.20 (~CLK); also elsewhere on the board
/~INT: PE1.18 (~INT); also elsewhere on the board
/~IORQ: PE1.14 (~IORQ); also elsewhere on the board
/~M1: PE1.22 (~M1); also elsewhere on the board
/~RD: PE1.16 (~RD); also elsewhere on the board
/~RESET: PE1.21 (~RESET); also elsewhere on the board
/~WAIT: PE1.19 (~WAIT); also elsewhere on the board
/~WR: PE1.17 (~WR); also elsewhere on the board
GND: CE1.2, PE1.23 (GND); also elsewhere on the board
VCC: CE1.1, PE1.24 (VCC); also elsewhere on the board

Notes on the sheet:
Decoupling

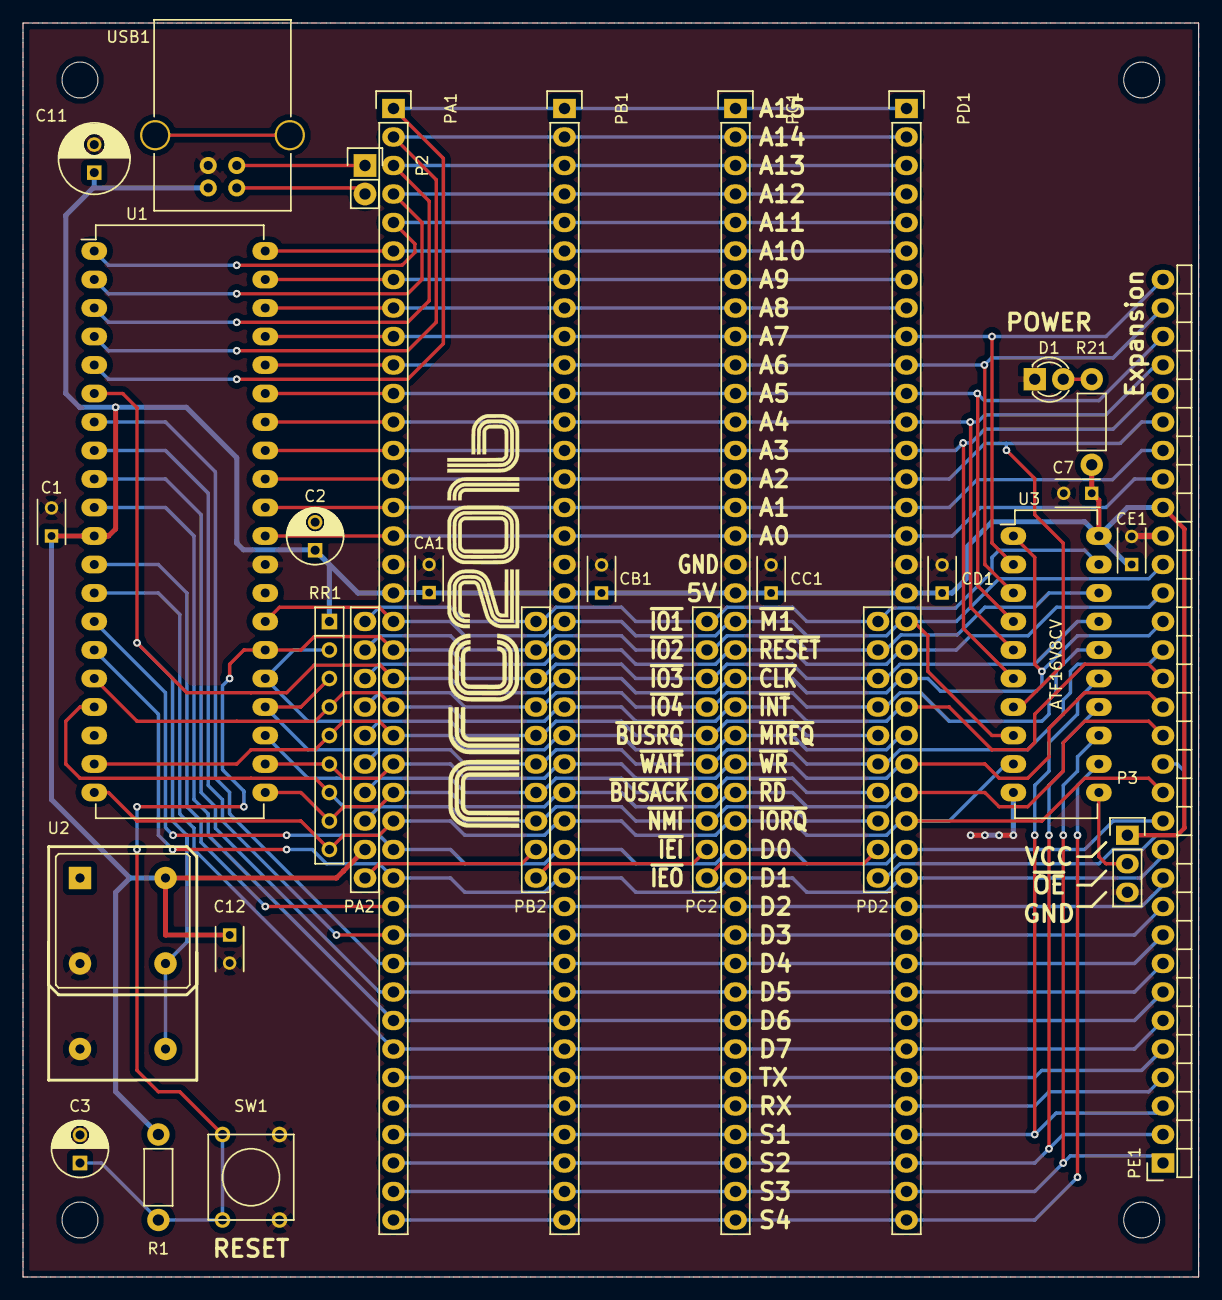
[picture p10: board z80.kicad_pcb from above]

Board: 2 copper layers, 104.8 x 111.8 mm, 37 parts (0 on the bottom side), 56 nets.
