alangarf/NRC2016/(commit log)

2016-07-03 Added first WIP schema of the new base board with CPU, Clock and APIA onboard
2016-07-04 Added kicad source for cpu and root sheet
    [cpu.sch, z80.kicad_pcb, z80.sch]
2016-07-05 Started on bus_port schema
    [bus_port.sch, cpu.sch, z80.sch]
2016-07-08 More WIP added hierarchical sheets for bus
    [bus_port.sch, card_bus.sch, cpu.sch, z80.kicad_pcb, z80.sch]
2016-07-08 Added seperate power pin slots to stop inserting cards backwards
    [bus_port.sch, card_slots.sch, cpu.sch, z80.sch]
2016-07-08 More card slot clean up. Added NMI signal for DMA
    [bus_port.sch, card_slots.sch, cpu.sch, z80.sch]
2016-07-08 Added IO sheet, fixed pin types to match z80
    [IO.sch, bus_port.sch, card_slots.sch, cpu.sch, z80.sch]
2016-07-08 Added IO address decoder, 8 IO slots, partial IO bus buffering. Still to decide: what to do with all the /INT pins? TODO: add bi-directional data bus buffering (2x 74AC241?) for IO boards. This thing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
    [IO.sch, IO_bus.sch, bus_port.sch, card_slots.sch, cpu.sch, z80.sch]
2016-07-10 Added missing signals to IO and added buffer
    I've removed the /WAIT and also added a somewhat dodgy diode AND to
    handle the bi-directional Dx buffer. Might work, might not.
    Also cleaned up the buses and just tidied things up.
    [IO.sch, IO_bus.sch, bus_port.sch, card_slots.sch, cpu.sch, z80.kicad_pcb, z80.sch]
2016-07-10 Added /intack signal and a pri-encoder for /iosel
    Brain fart on the diode crap. Was tired. Added a priority encoder to
    enable the Dx buffer so it properly tristates when no IObus ports are
    selected.
    Added a NOR gate to provide a /intack signal for any board to properly
    detect their interupt has been accepted but the z80. Boards will need to
    figure out who the interupt is for.
    Will have to add interupt priority pins to the boards to allow the
    boards to put jump vectors onto the data bus to service the interrupt
    This should be fairly easy, just means the service pritority of the
    slots will be A-H, with A being the highest priority and H being the
    lowest.
    Going to replace the hex inverters w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
    [IO.sch, IO_bus.sch, bus_port.sch, card_slots.sch, cpu.sch, z80.sch]
2016-07-10 Added interrupt priority pins to bus
    These pins allow the boards to accept an interrupt assert priority of
    the recieved interrupt ACK and load the data bus with a jump offset to
    an ISR. Once a board has assert priority it sets it's IEO low so all
    lower priority boards know the interrupt ACK wasn't for them and to try
    again.
    This will be a beast!
    [IO.sch, IO_bus.sch, bus_port.sch, card_slots.sch, cpu.sch, z80.sch]
2016-07-10 Removed the interrupt priority circuitry
    After second thought the added complexity just wasn't worth it.
    [IO.sch, IO_bus.sch, bus_port.sch, z80.sch]
2016-07-20 Added basic board layout WIP
    Switched a few bus lines around to make the layout a little easier.
    Still learning PCBNew, has a few quirks I haven't figured out yet.
    [IO.sch, IO_bus.sch, bus_port.sch, cpu.sch, z80.kicad_pcb]
2016-07-20 Updated LEDs, added power supply options, added mounting holes in schematic.
    [IO.sch, IO_bus.sch, bus_port.sch, card_slots.sch, cpu.sch, z80.sch]
2016-07-21 Update PCB, better layout. Got Addr bus back in order
    Think having both USB and DC input would be useful. Switchmode a plus
    then plugpack/battery etc voltage doesn't matter. Plus I have a bag full
    of those parts too!
    I've refdes'd the linear reg just to deal with the net. Will remove if
    we both are happy with switcher. Linear cheaper to kit out I guess.
    Was trying to find a better way to combine USB and DC power rails than
    just schottky diodes. If you have any ideas.
    Going to have a big area under the IO ports, might be worth adding a USB
    to serial, or sacrifice a IO port for some blinky LEDs and buttons?
    [IO.sch, IO_bus.sch, bus_port.sch, cpu.sch, z80.kicad_pcb, z80.sch]
2016-07-21 Just tidied up the addr lines from z80
    Dual layer board, why not use it to space out a bit better. :)
    [z80.kicad_pcb]
2016-07-21 Added logo 'footprints'
2016-07-21 Added logo to pcb.
    [z80.kicad_pcb]
2016-07-21 Now for real ..
    [z80.kicad_pcb]
2016-07-22 PCB layout complete, passes DRC, more tuning required
    One thing not enough buffers for all address lines (missed A5), so
    swapped out the CLK. Not sure if that was a good idea, but didn't want
    to add another chip for a single buffer. :(
    [IO.sch, IO_bus.sch, bus_port.sch, cpu.sch, z80.kicad_pcb, z80.sch]
2016-07-23 Update with smaller board and through-hole parts.
    [IO.sch, IO_bus.sch, bus_port.sch, card_slots.sch, cpu.sch, z80.kicad_pcb, z80.sch]
2016-07-24 Smaller, through hole, done!
    Apart from maybe a few footprint issues and a bit of trace fiddling this
    should be pretty close. Be interesting how much this will cost now. :)
    [IO.sch, IO_bus.sch, bus_port.sch, cpu.sch, z80.kicad_pcb]
2016-07-24 Change to 7 mils clearance to make cheaper
    7 mils seems to be the minimum clearance for the cheap board houses. So
    reworked the board to match.
    [cpu.sch, z80.kicad_pcb]
2016-07-24 Few more trace tweaks, gave xtal more space.
    [z80.kicad_pcb]
2016-07-24 ugh another tweak. OCD will kill me.
    [z80.kicad_pcb]
2016-07-31 New layout complete. Now with rc2014 compat. slots!
    Plus on board address decoding, single stepping using M1 line so button
    is click per instruction. Board is also much smaller!
    [IO.sch, IO_bus.sch, bus_port.sch, card_slots.sch, cpu.sch, z80.kicad_pcb, z80.sch]
2016-07-31 Flipped the decoupling caps around for neatness
    [z80.kicad_pcb]
2016-07-31 Another new board layout. Few tidy ups.
    Removed the single step circuit, not worth the board space and headache.
    Added legend for the IO slot for easy reference. Still toying where to
    put the power LED, annoying me with that resistor. Think I'm happy with
    it now. Spaced things out a little to make it easy for manufacture, made
    sure no traces are near board edges as much as possible.
    [bus_port.sch, card_slots.sch, cpu.sch, z80.kicad_pcb, z80.sch]
2016-08-01 Hopefully the final layout
    [z80.kicad_pcb]
2016-08-01 Can't help myself, damn you OCD!
    [z80.kicad_pcb]
2016-08-04 * added USB data signals to first slot * added logo to the top of the board. * added logo PNG files.
    [bus_port.sch, z80.kicad_pcb, z80.sch]
2016-08-05 Added RAM board schema with GAL
    - Created symbols for 62256 and ATF16V8CV
    - Added start of the RAM board schematic
    [nrc2016-RAM.kicad_pcb, nrc2016-RAM.sch]
2016-08-05 Added decoupling caps to RAM board schematic
    [nrc2016-RAM.sch]
2016-08-10 * Replaced one card slot with an updated expansion connector. * Replaced '138 with GAL. * Implemented interrupt priority lines IEI/IEO. * Replaced discrete oscillator with 14/8 pin DIP oscillator blo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
    [bus_port.sch, card_slots.sch, cpu.sch, expansion_port.sch, z80.sch]
2016-08-14 Fixed schema DRC errors
    [bus_port.sch, card_slots.sch, cpu.sch, expansion_port.sch, z80.sch]
2016-08-14 Added new expansion and GAL to layout.
    Haven't routed the osc. or the reset.
    [bus_port.sch, card_slots.sch, cpu.sch, expansion_port.sch, z80.kicad_pcb]
2016-08-14 Updated layout to clean up the power rails
    [z80.kicad_pcb]
2016-08-14 Noticed missing pin I6 on GAL, added A2 input
    [card_slots.sch, z80.kicad_pcb]
2016-08-15 More OCD PCB fiddling, cleaning up traces etc
    [z80.kicad_pcb]
2016-08-15 Silkscreen tweaking
    [z80.kicad_pcb]
2016-08-15 Removed the RAM board, not much point at the moment.
    Bank switching much more attractive option to rework.
    [nrc2016-RAM.kicad_pcb, nrc2016-RAM.sch]
2016-08-15 Removed old IO bus port and hierarchical sheet
    [IO.sch, IO_bus.sch]
2016-08-15 Added symbol for Z80_SIO2 device.
    Pins are correct, but their types in KiCad are all wrong. They're all
    currently inputs when they need to reflect the datasheet directions so
    DRC will work. Will fix later
2016-08-15 Added new usb_sio board.
    This board will use a MCP2200 USB controller with hardware flowcontrol
    and a Z80 SIO/2 dual UART.
    [usb_sio.kicad_pcb, usb_sio.sch]
2016-08-15 More silkscreen tweaks
    [z80.kicad_pcb]
2016-08-15 Even more silkscreen tweaking
    [z80.kicad_pcb]
2016-08-16 Added logo schematic elements and new logo for bottom side.
    [bus_port.sch, card_slots.sch, cpu.sch, expansion_port.sch, z80.kicad_pcb, z80.sch]
2016-08-16 Dunno what changed. . ?
    [z80.sch]
2016-08-17 * fixed DRC errors on pin 1 of Px2 connectors. * fixed unconnected ground pin issue of GAL. * added 8DIP and 14DIP oscillator block footprint. * updated bottom silkscreen. * added via stitching in a 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
    !! This is NRC016 RC1 !!
    [bus_port.sch, cpu.sch, z80.kicad_pcb, z80.sch]
2016-08-21 Moved the slot a little further apart.
    [z80.kicad_pcb]
2016-08-21 updated bottom logo.
    [z80.kicad_pcb]
2016-08-21 fixed a VCC trace.
    [z80.kicad_pcb]
2016-09-03 Fix screw up with VCC and GND on rc2014 slots.
    [bus_port.sch, z80.kicad_pcb]
2016-09-09 Moved directory layout around to clean things up
    .. for future work etc.
    [bus_port.sch, card_slots.sch, cpu.sch, expansion_port.sch, usb_sio.kicad_pcb, usb_sio.sch, z80.kicad_pcb, z80.sch]
2016-09-10 Fixed up project paths and pcb footprint path moves
    [z80.kicad_pcb]
2016-09-10 Update nrc2016 schema and PCB to use new library symbols
    I've added proper schematic symbols for the pre-defined bus sockets to
    stop confusion and error by just using the generic "library" socket
    component and then relying on the net names to define the pins. Screwed
    me once with the VCC and GND switch around, not going to happen again.
    [bus_port.sch, card_slots.sch, cpu.sch, expansion_port.sch, usb_sio.sch, z80.kicad_pcb, z80.sch]
2016-09-10 More moving things around. Added sockets and pins symbols
    Makes it easier for DRC and has hints for the right footprints already.
    [bus_port.sch, expansion_port.sch, usb_sio.sch, z80.kicad_pcb, z80.sch]
2016-09-10 Added schematic for a nrc2016 USB upgrade board for 68B50
    This could be an upgrade board for owners of an rc2014 and reuse their
    existing 68B50. It uses the IOSEL lines and also puts an appropriate
    oscillator so the 68B50 isn't overclocked to heck.
    Also uses a MCP2200 USB to serial converter that does hardware flow
    control and will have available GPIO for remote I/O using the Microchip
    library (remote reset?).
    I've made it so the 68B50 oscillator is optional and can continue to run
    from the CPU clk.
    [usb_sio.sch]
2016-09-11 Added LEDs and an inverter to the SIO board
    [usb_sio.sch]
2016-09-11 Fixed missing CLK like on SIO board
    [usb_sio.sch]
2016-09-11 WIp on the SIO PCB
    [usb_sio.kicad_pcb, usb_sio.sch]
2016-09-12 Added major work to SIO board.
    Coming along nicely. Had to use SOIC for the USB to serial converter. :(
    [usb_sio.kicad_pcb, usb_sio.sch]
2016-09-13 Update to the SIO board, layout complete!
    Added headers for selecting the IOSEL to use, added logo, silkscreen
    legends etc.
    [usb_sio.kicad_pcb, usb_sio.sch]
2016-09-14 Added prelim schema for a banked RAM and ROM board
    It uses IOSEL for paging in 1 of 4 banks in the lower half of the
    address range.
    BANK0 - ROM
    BANK1 - RAM 32K
    BANK2 - external RAM
    BANK3 - external RAM
    [banked_ram.kicad_pcb, banked_ram.sch]
2016-09-17 Banked RAM board completed
    [banked_ram.kicad_pcb, banked_ram.sch, usb_sio.kicad_pcb]
